ADXBD/Stratos-A2M1RAK/Component_Stratos A2M1RAK MOD2 Mount Battery Board.step

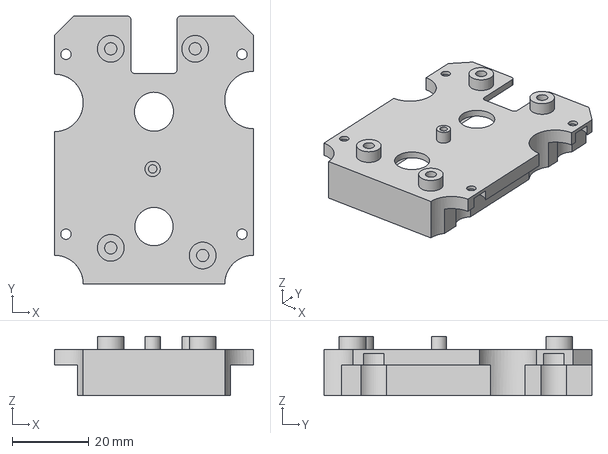
[picture p1: CAD file, 2025-06-04]
Component_Stratos A2M1RAK MOD2 Mount Battery Board.step
52.0 x 70.0 x 15.5 mm
