ADXBD/Stratos-A2M1RAK/Component_Stratos A2M1RAK MOD2 Antenna Gasket.step

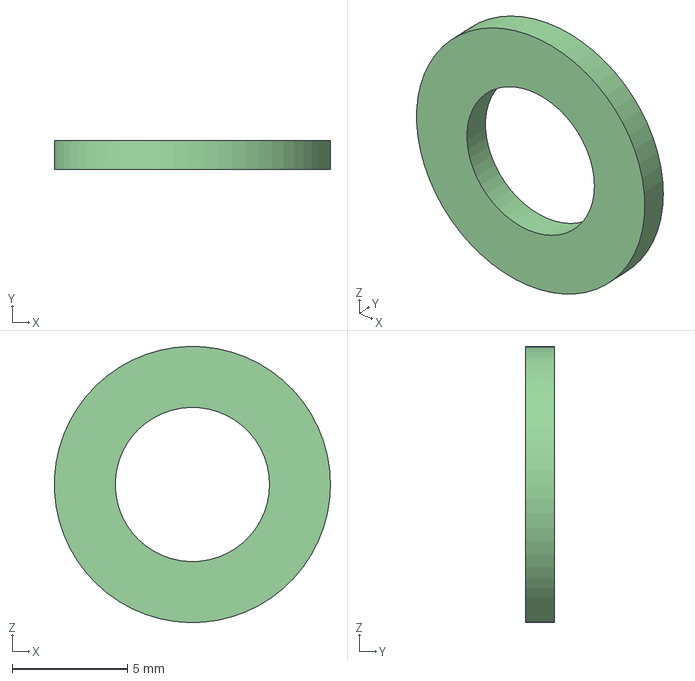
[picture p2: CAD file, 2025-06-04]
Component_Stratos A2M1RAK MOD2 Antenna Gasket.step
12.0 x 1.25 x 12.0 mm
