ADXBD/Stratos-A2M1RAK/Component_Stratos A2M1RAK MOD2.step

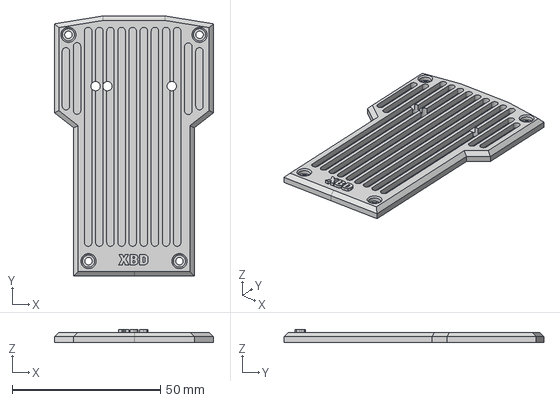
[picture p3: CAD file, 2025-06-04]
Component_Stratos A2M1RAK MOD2.step
53.6 x 87.6 x 4.50 mm
