ADXBD/Stratos-A2M1RAK/Project_Stratos A2M1RAK MOD2.3mf

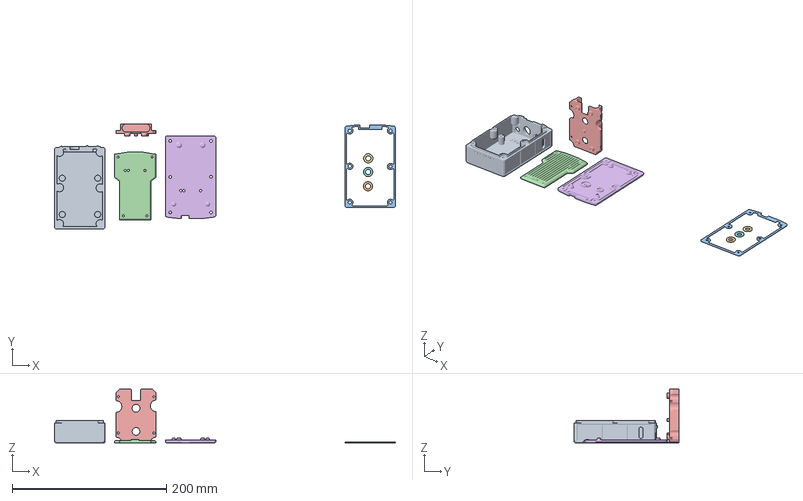
[picture p4: CAD file, 2025-06-04]
Project_Stratos A2M1RAK MOD2.3mf
442.2 x 135.6 x 70.0 mm
Bottom .step
Antenna Gasket.step x 3
Gasket.step
Light Cover 3.5m.step
Mount Battery Board.step
Top.step
