ADXBD/Stratos-A2M1RAK/Component_Stratos A2M1RAK MOD2 Bottom .step

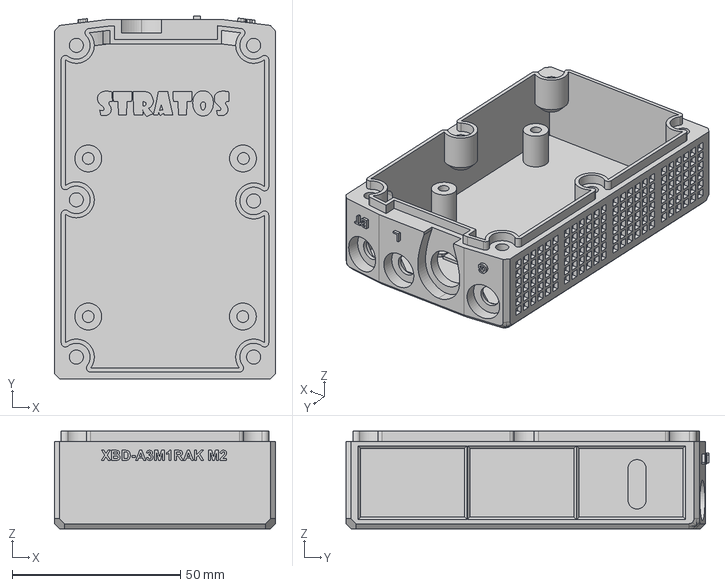
[picture p5: CAD file, 2025-06-04]
Component_Stratos A2M1RAK MOD2 Bottom .step
65.8 x 107.9 x 29.1 mm
