ADXBD/Stratos-A2M1RAK/Component_Stratos A2M1RAK MOD2 Gasket.step

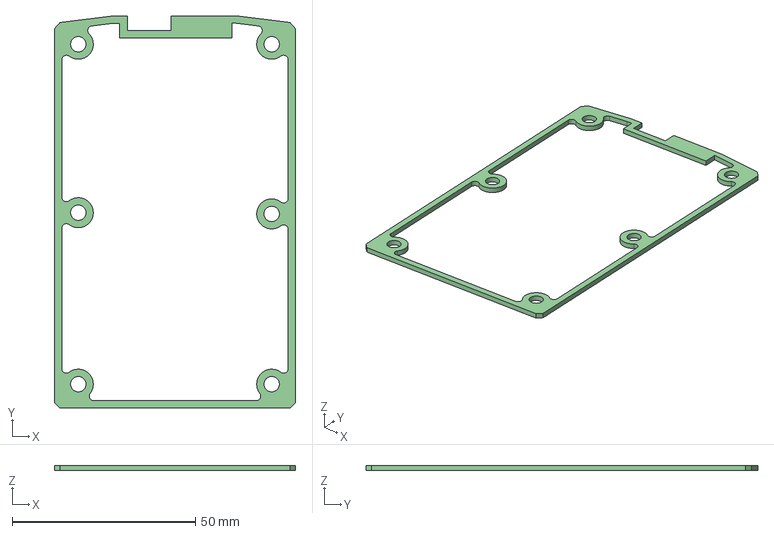
[picture p6: CAD file, 2025-06-04]
Component_Stratos A2M1RAK MOD2 Gasket.step
65.8 x 106.9 x 1.50 mm
