ADXBD/Stratos-A2M1RAK/Component_Stratos A2M1RAK MOD2 Top.step

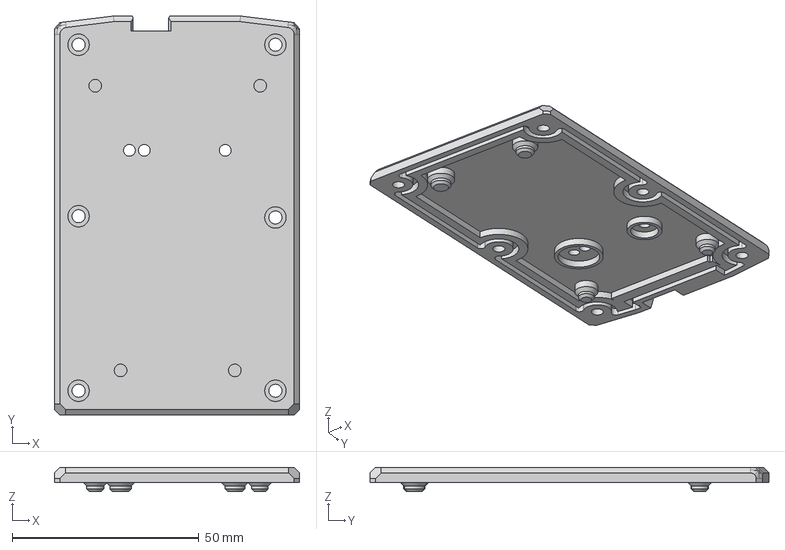
[picture p7: CAD file, 2025-06-04]
Component_Stratos A2M1RAK MOD2 Top.step
65.8 x 106.9 x 6.50 mm
