ADXBD/Stratos-A2M1RAK/(commit log)

2025-06-04 Import Files
    [Component_Stratos A2M1RAK MOD2 Antenna Gasket.step, Component_Stratos A2M1RAK MOD2 Bottom .step, Component_Stratos A2M1RAK MOD2 Gasket.step, Component_Stratos A2M1RAK MOD2 Mount Battery Board.step, Component_Stratos A2M1RAK MOD2 Top.step, Component_Stratos A2M1RAK MOD2.step, Project_Stratos A2M1RAK MOD2.3mf]
2025-06-04 Print Files
    [Component_Stratos A2M1RAK MOD2 Antenna Gasket.step, Component_Stratos A2M1RAK MOD2 Bottom .step, Component_Stratos A2M1RAK MOD2 Gasket.step, Component_Stratos A2M1RAK MOD2 Mount Battery Board.step, Component_Stratos A2M1RAK MOD2 Top.step, Component_Stratos A2M1RAK MOD2.step, Project_Stratos A2M1RAK MOD2.3mf]
